Misu03/Audio-Input-Preamplifier/README.md

# Audio-Input-Preamplifier
Projected the design of an audio frequency input preamplifier consisting of an input matching network with the main audio signal sources (microphone or any other output signals from electronic audio devices), and two amplification stages.
