Misu03/Audio-Input-Preamplifier/Proiect docs/2025_433A_Nuică_Mihai_Călin_PAI_N21_SMT.docx

Universitatea “Politehnica” din Bucuresti Facultatea de Electronica, Telecomunicatii si Tehnologia Informatiei

PROIECT 1

PREAMPLIFICATOR AUDIO DE INTRARE

Student: Nuică Mihai-Călin

Grupa: 433A

Prof. Coordonator BABARADA Florin

Bucuresti, 2024

1. TEMA DE PROIECTARE

Tema de proiectare se referă la un preamplificator de audiofrecvenţă de intrare având schema bloc prezentată în Figura 1. Amplificatorul audio de intrare este compus din o reţea de adaptare la intrare cu principalele surse de semnale audio (microfon, pick-up cu doză magnetică, pick-up cu doză ceramică, radio, magnetofon sau alte ieşiri de semnal ale aparatelor audio electronice) şi două etaje de amplificare în clasa A, respectiv etajul de intrare şi etajul de ieşire care realizează amplificarea în tensiune a semnalului.

Amplificarea globală a amplificatorului audio de intrare este stabilită de reacţie negativă serie la intrare-paralel la ieşire iar alimentarea celor două etaje de amplificare este realizată de sursa de alimentare.

Reactie negativa

iesire

Microfon

Etaj de intrare A

Etaj de iesire A

Figura 1. Schema bloc a amplificatorului audio de intrare

2. DATE DE INTRARE

Principalii parametrii de intare ai amplificatorului audio sunt:

• Sensibilitatea minimă la intare Vin (mV)

• Rezistența de intrare Rin(kOhm)

• Rezistența de ieșire maximă R0M(kOhm)

• Tensiunea nominală la ieșirea amplificatorului audio de putere Vn (Vef)

Valorile folosite pentru proiectarea amplificatorului pot fi consultate în tabelul următor:

N | Vin [mV] | Rin [kΩ ] | R0M [kΩ ] | Vn [mV]
21 | 2,5 | 40 | 3 | 1,5

3. SCHEMA ELECTRONICĂ

Preamplificatorul este partea care influenţează cel mai pregnant raportul semnal zgomot, caracteristica de frecvenţă şi factorul de distorsiuni într-un lanţ de amplificare de audiofrecvenţă.

In practică există adesea şi alte semnale numite semnale false, care tind să interfereze cu semnalele dorite şi acestea se numesc în general semnale de zgomot. Un obiectiv important în proiectare este realizarea unui bun raport semnal zgomot, cu toate ca zgomotul nu poate fi eliminat complet.

Un preamplificator sensibil si relativ nezgomotos constituie o problemă importantă daca urmează ca la ieşire zgomotul sa fie minim deoarece orice zgomot din preamplificator este amplificat de fiecare etaj care urmează.

Amplificarea în tensiune este realizată de etajul de intrare şi cel de ieşire. Etajul de intrare este de tipul emitor comun cu sarcină distribuită şi este realizat cu tranzistorul T1. Etajul de ieşire este cuplat galvanic cu etajul de intrare şi este de tip emitor comun, realizat cu tranzistorul T2.

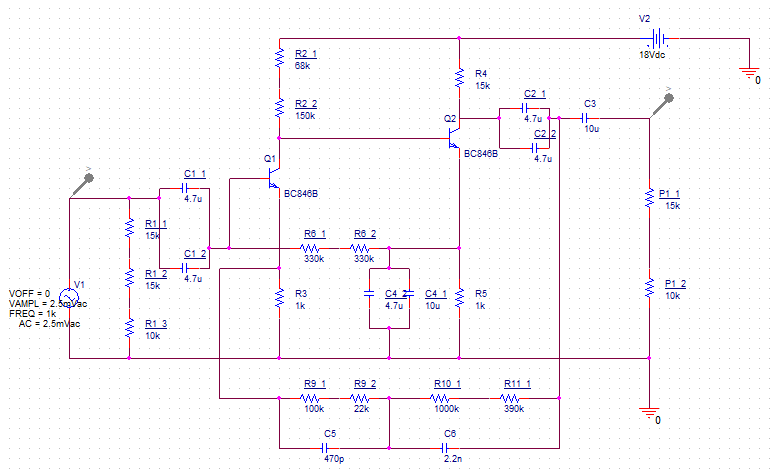
[picture p1: figure]

4. ETAJELE DE AMPLIFICARE

Având în vedere faptul că intrarea amplificatorului de putere necesită la intrare un semnal cu amplitudinea de 1,5 Vef, iar amplificatorul corector de ton sau alte etaje intermediare au amplificarea de aproximativ 5, semnalul la ieşirea preamplificatorului de intrare trebuie să aibă o amplitudine de 1,5/5=0,3Vef respectiv amplitudinea maximă de 0,3 * ∗ √2 = 0,42V. Se alege acoperitor o valoare de 0,6V (valoare instantanee maximă). Sensibilitatea la intrare asigură un nivel minim egal cu cel al unui microfon dinamic respectiv 2,5mV.

I) ALEGEREA TRANZISTORILOR T1 SI T2

Nivelul mic al semnalului de intrare impune alegerea pentru etajele de amplificare a unor tranzistoare cu zgomot mic de tip BC846B cu următoarele PSFuri:

T1: Pe baza curbelor izo-F, din catalog pentru BC846B, se alege IC1=70μA la care pentru rezistenţa generatorului Rg=2÷20k⇒F≤2dB. Se alege VCE1≥≈2V.

Din catalog în acest PSF rezultă:

h11e1 = rbe1 ≈ 150 kΩ

h21e1 = β1 ≈ 300

h22e1 = 18 μA/V

h21E1 ≈ 350

T2: Ic2 ≈ 0.8mA și VCE2 ≈ 5V

Din catalog în acest PSF rezultă:

h11e2 = rbe2 ≈ 15kΩ

h21e2 = hFE = β2 ≈ 300

h22e2 = 55 μA/V

h21E2 ≈ 170

II) AMPLIFICARE IN TENSIUNE

Amplificarea în tensiune a etajului de intrare care este de tipul emitor comun cu sarcină distribuită este:

AV, T1 = -(h11e2||(h22e1)^(-1) ||R2)/(R3)

Considerand: R2 ≫ h11e2‖h22e1 => AV,T1 ≤ -(h11e2||(h22e1)^(-1))/(R3) = -(15k||55k)/(R3) = -(11.78k)/(R3)

Pentru obținerea unor distorsiuni tranzitorii mici se impune o amplificare redusă, cu reacție locala AV,T1 ≈ -10. Din acest motiv alegem R3 = 1kΩ.

Din condițiile: R2 ≫ h11e2‖h22e1 ⁻¹

VCE1 ≈ EC − (R2 + R3)*Ic1 ≈ 2V

Se aleg R2 = 218kΩ si Ec=18V.

Se poate calcula exact VCE1:

EC=R2*(IC1+IB2)+VCE1+R3*IC1 cu IB2= (IC2)/(h21E2) ≈ 5.8μA =>

VCE1=18V-220kΩ*75.8μA-1kΩ*70μA = 1.254V este mai mare decat amplitudinea semnalului la iesirea etajului de intrare.

Considerand VR2=R2*(IC1+IB2) ≈ 16.6V şi aproximând VBE2 = 0,6V =>

VR5=EC- VR2-VBE2=0.8V

Se alege R5 = 1kΩ => IC2 = 0,8mA

Ecuația dreptei de sarcină pentru T2: Ec = (R4 + R5)*Ic2 + VCE2 =>

R4 ≈ (Ec-VR5-VCE2)/(Ic2) = (18V-0.8V-5V)/(0.8mA) = 15.25kΩ, alegem R4=15kΩ, fiind cea mai apropiata valoare intreaga.

Amplificarea în tensiune a etajului de ieșire este:

AV, T2= -(h21e2*[R2||(h22e2)^(-1) ])/(Rg+h11e2) = -(300*(15k||18k))/(55k+15k) ≈ -35

Amplificarea în tensiune a etajului de intrare este:

AV, T1= -([h11e2||(h22e1)^(-1) ]*R2)/(h11e1+(h21e1+1)*R3) *h21e1 = -(11.9k*300)/450 ≈ -7.8

Amplificarea în tensiune a preamplificatorului în buclă deschisă este:

AV= AV, T1*AV, T2= (-7.8)*(-35)= 273

III) IMPEDANTA DE IESIRE

Impedanța de intrare în buclă deschisă a preamplificatorului este:

ZinT1=[h11e1+(h21e1+1)R3]‖R6

R6 se dimensionează ținand cont de necesitatea polarizării bazei tranzistorului T1:

R6IB1 = VR5 − VBE,T1 − VR3 = 0,8 − 0,6 − 0,07 ≈ 0.13V

cu IB1= (IC1)/(h21E1) = 70/350 = 0.2μA => R6= (0.13V)/(0.2μA) = 650kΩ, alegem R6=660kΩ

ZinQ,1 = (150k + 300k)‖650k = 265kΩ

IV) DIMENSIONAREA CONDENSATORILOR

Din motive de stabilitate determinate grafic pe caracteristica BODE, alegem pentru polul dat de C4 la frecvența f4p ≈ 5 ÷ 10 Hz (7Hz).

Rezistența văzută la bornele lui C4 este:

RC4p= R5 ‖ (h11e2+R2||(h22e1)^(-1))/(h21e2) = 1k ‖ (15k+220k‖55k)/300 =165 Ω

C4 ≈ 1/(2*π*f4p*Rc4p) = 137 μF , se alege 14.7 μF (pt. a reduce nr. de condensatoare in paralel necesare)

Avand în vedere că R1 se alege astfel încat imprendanța văzută spre amplificator să fie ≈47kΩ, necesară pentru adaptarea cu doza magnetică și alegand f1 = 0,3Hz

C1= 1/(2*π*0.3*47k) = 11.29μF, se alege C1= 9.4μF

Pentru dimensionarea C2 se apreciază că impendața la bornele sale nu este mai mică de 50kΩ. Se alege f2 = 0,3Hz

C2= 1/(2*π*0.3*Rc2) = 13.8 μF, se alege C2= 9.4μF

Impedanța de ieșire a preamplificatorului fără reacție negativă este:

Zout,T2 = R4‖h22e2 ⁻¹ = 15k‖18k = 8,2kΩ

Cu reacție negativă avand în vedere necesitatea de amplificare pentru o valoare medie βr=100⁻¹ impendața de ieșire este:

Zout ≈ (Zout,T2)/(βr*Av) = (8.2k)/2.73 = 3kΩ

Se poate accepta ca valoare minima a rezistorului P1=25kΩ, valoarea maximă de aproximativ 100kΩ e impusă de intrarea în circuitul corector de ton. Valoarea lui C3 s-a ales C3=10μF pentru P1 =25kΩ.

V) REACŢIA NEGATIVĂ ŞI REŢELELE DE ADAPTARE

Pentru estimarea nivelului nominal al semnalului la ieşirea preamplificatorului cunoaştem:

• Amplitudinea nominală a semnalului la intrarea în amplificatorul final Vnom. aap = 1,5Vef

• Amplificarea circuitelor intermediare de aproximativ 5

• Atenuarea introdusă de P1 = 0,9 Þ Vout, pa = 330mV

Reţelele de adaptare se dimensionează în raport cu acest nivel şi nivelele tipice ale surselor de program. S-au adoptat următoarele categorii de surse de semnal corespunzătoare cu tema de proiectare:

Sursa | Rezistența de intrare Ri [kΩ] | Sensibilitate Vin [mV]
Microfon | 40 | 100mVef

Pentru intrarea de microfon şi pick-up magnetic se proiectează o reţea de reacţie egalizatoare, care să corecteze caracteristica de frecvenţă a dozei magnetice. S-a adoptat corecţia după norma R.I.A.A, în care se impun următoarele constante de timp: t1=318µs, t2=75µs, t3=3180µs.

Considerând o reacţie suficient de puternică astfel încât să se poată scrie: AVr=1/βr şi având βr ≈ R3/Z(ω), unde Z(ω) este impedanţa grupului format din R9, R10, C5, C6 Þ AVr ≈ Z/R3 = K * Z(ω).

Practic la 1KHz se poate considera Z(ω) ≈ R9 şi atunci AVr ≈ 330mV/2,5mV = 132 .

Þ R9 ≈ R3 * AVr = 132kΩ . Aleg R9 = 122 kΩ

Þ R10 =11,8 * R9 = 1439,6kΩ.

Se adoptă R10 = 1390KΩ.

C5 = t2 / R9 = 0,56 nF. Se alege C5 = 470 pF.

C6 = t3 / R10 = 2,1 nF. Se alege C6 = 2.2 nF

5. SIMULAREA FUNCŢIONĂRII PREAMPLIFICATORULUI AUDIO DE INTRARE

Simularea preamplificatorului audio de intrare s-a facut din punct de vedere al PSF-ului, al analizei tranzitorii și al raspunsului in frecvență. Simularea PSF-ului ne dă o bună concordantă cu datele de proiectare respectiv curenții de colector și tensiunile colector-emitor

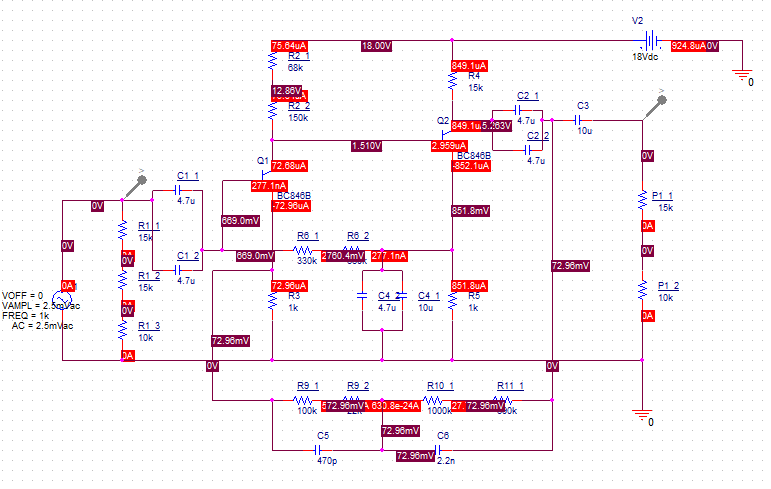
[picture p2: figure]

Simularea punctului static de functionare al preamplificatorului

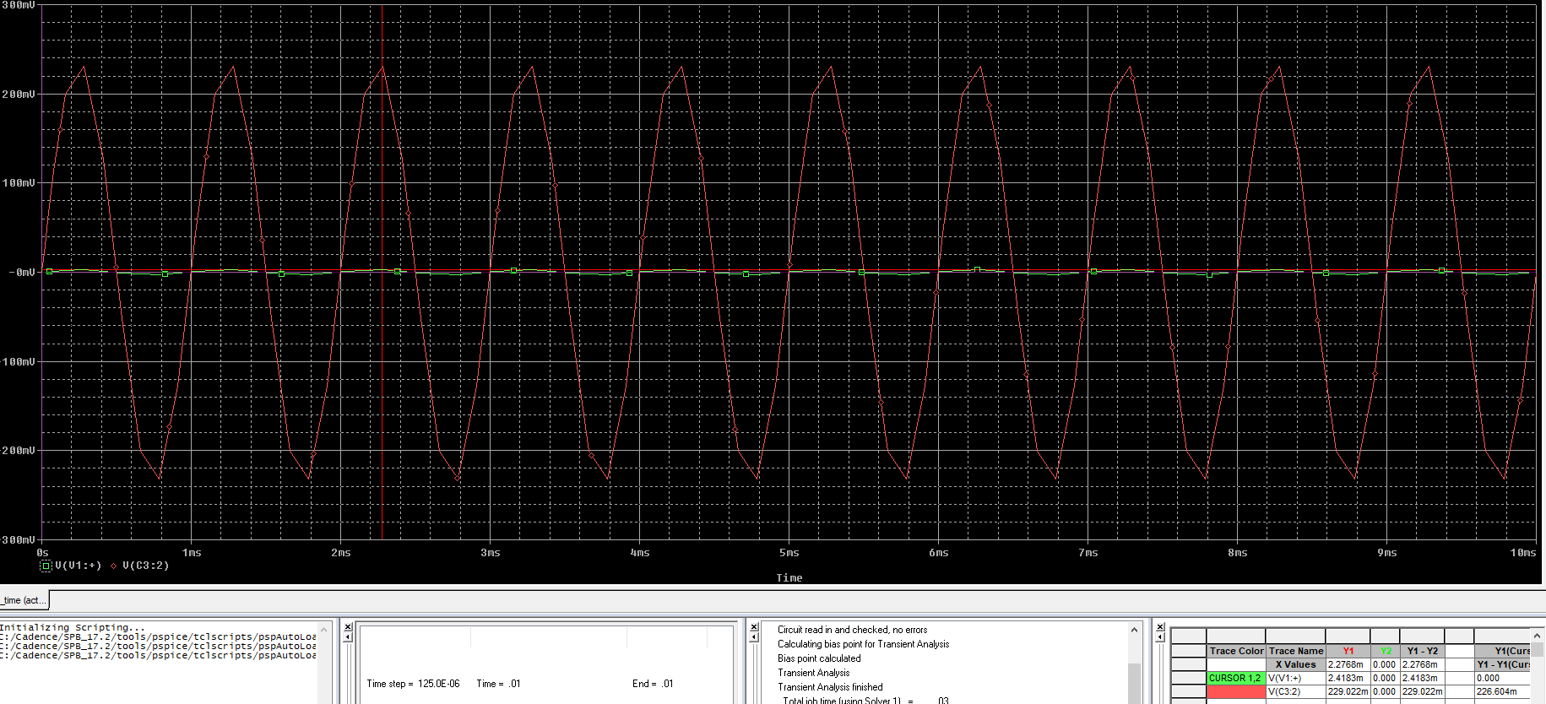
[picture p3: figure]

Simularea tranzitorie a preamplificatorului

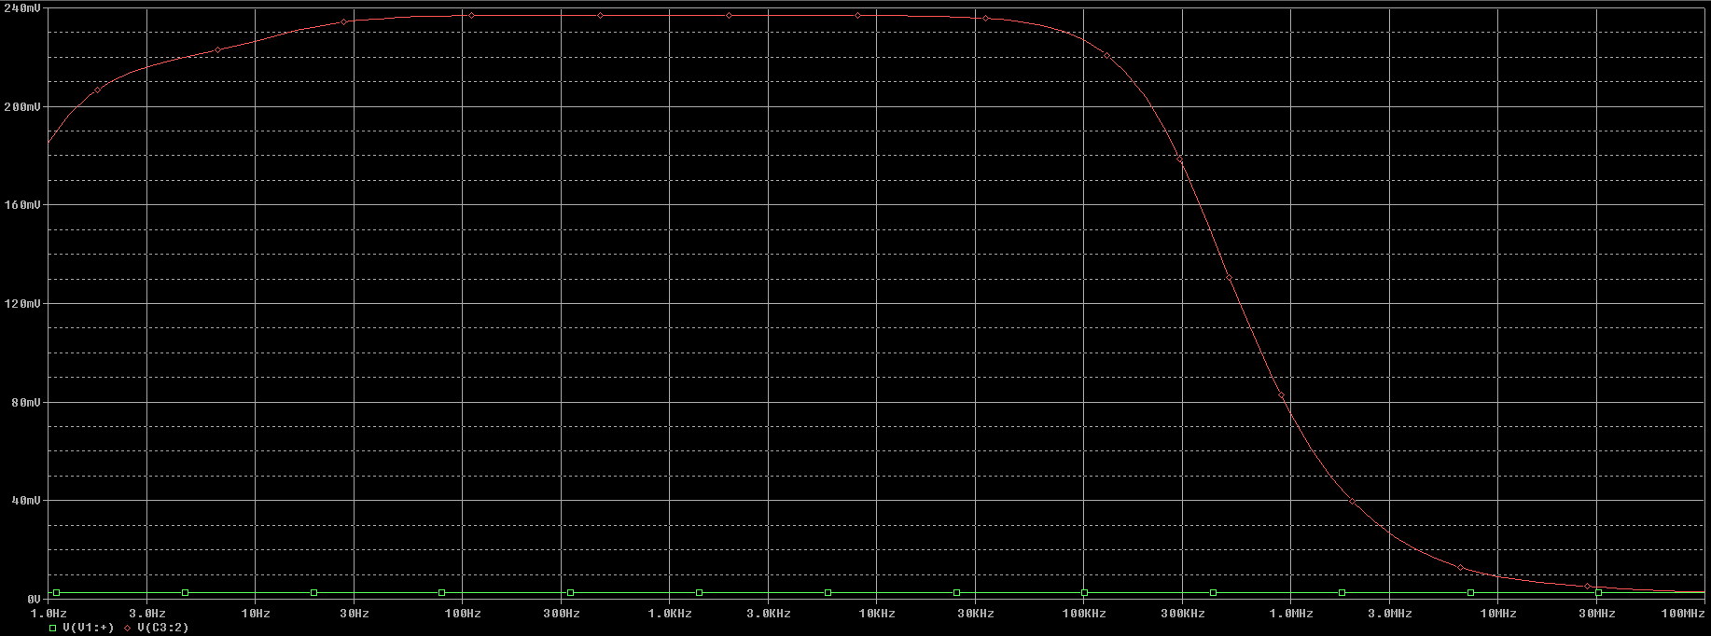
[picture p4: figure]

Simularea în frecvență a preamplificatorului

6. LISTA COMPONENTELOR

Lista componentelor preamplificatorului audio de intrare:

REZISTENTE:

R1_1=15kΩ ± 5% R1_2=15kΩ ± 5% R1_3=10kΩ ±5%

R2_1=68kΩ ±5% R2_2=150kΩ ±5%

R3=1kΩ ± 5%

R4=15kΩ ±5%

R5=1kΩ ±5%

R6_1=330kΩ ±5% R6_2=330kΩ ±5%

R9_1=100kΩ ±5% R9_2=22kΩ ±5%

R10_1=1MΩ ±5% R10_2=390kΩ ±5%

P1_1=15kΩ P1_2=10kΩ

CONDENSATORI

C1_1=C1_2=C2_1=C2_2=C4_2 = 4.7uF

C3=C4_1=10uF

C5=470pF

C6=2.2nF

TRANZISTORI

T1=T2=BC846B

6. FISIERELE GERBER

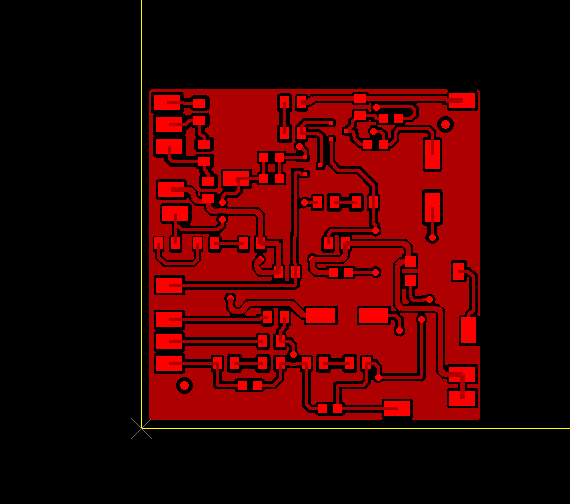
[picture p5: figure]

TOP

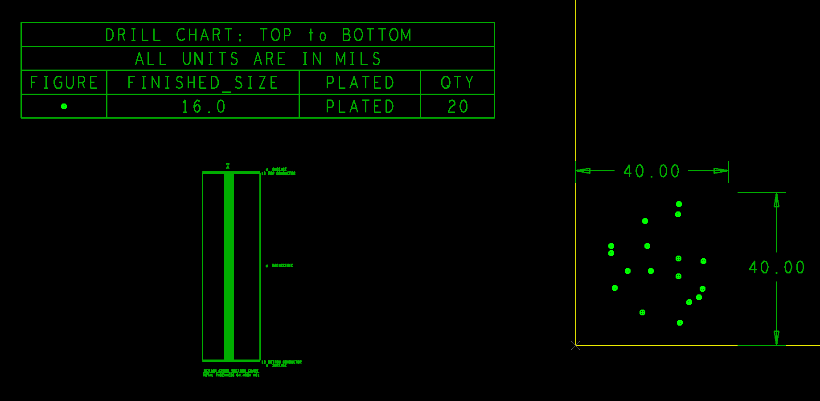
[picture p6: figure]

FAB

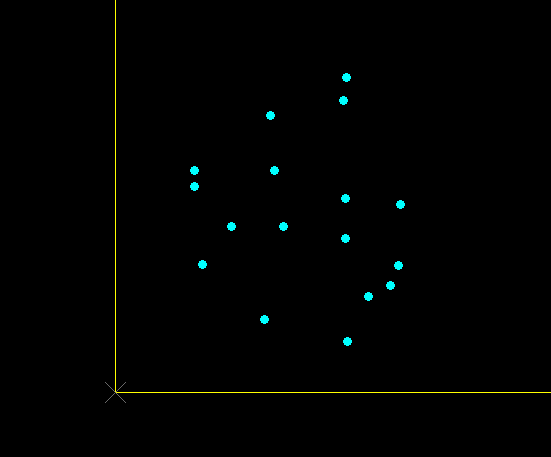
[picture p7: figure]

SMBOT

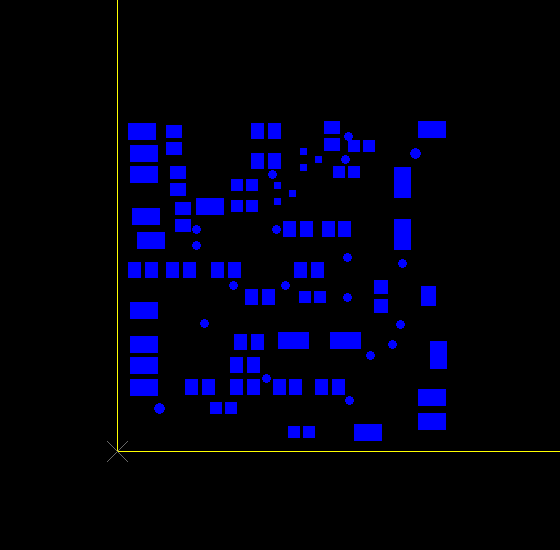
[picture p8: figure]

SMTOP

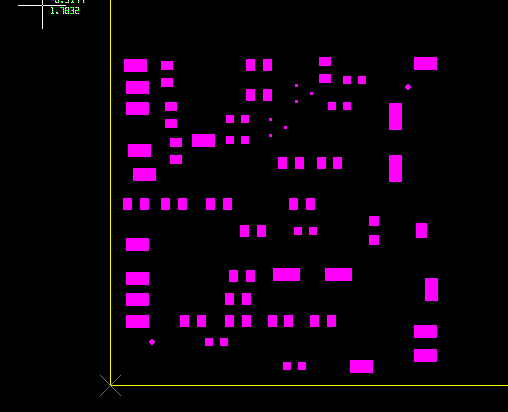
[picture p9: figure]

SPTOP

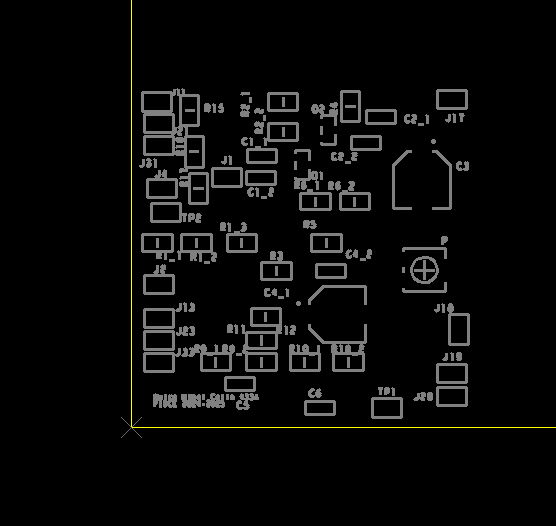
[picture p10: figure]

SSTOP

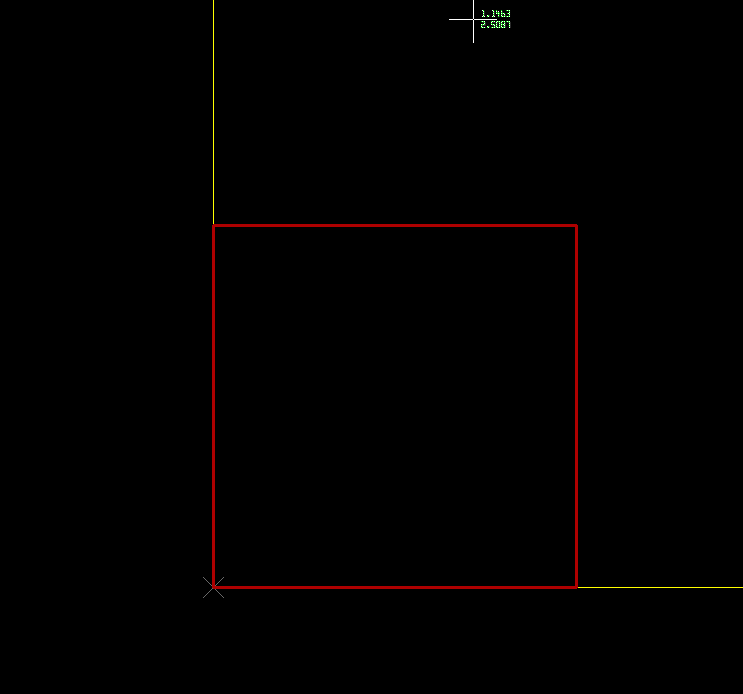
[picture p11: figure]

BO

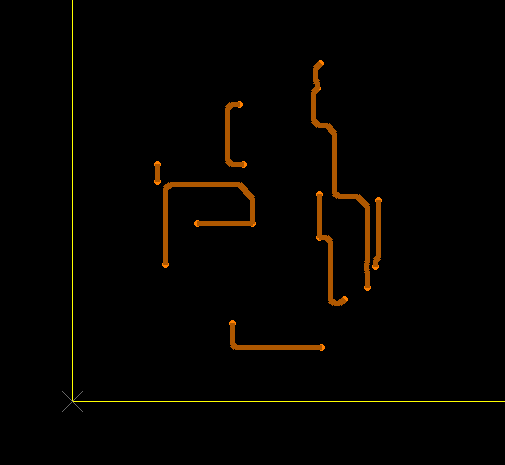
[picture p12: figure]

BOTTOM

7. Realizare si punere in functiune

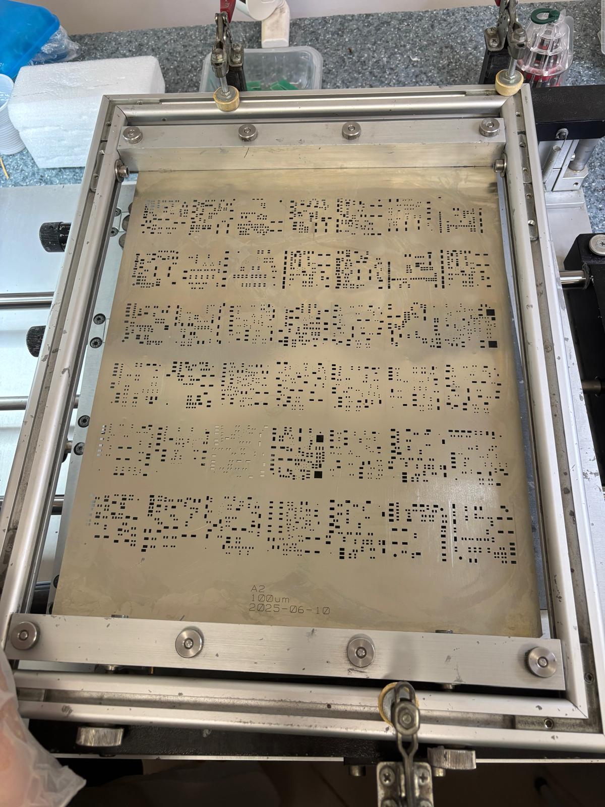
[picture p13: figure]
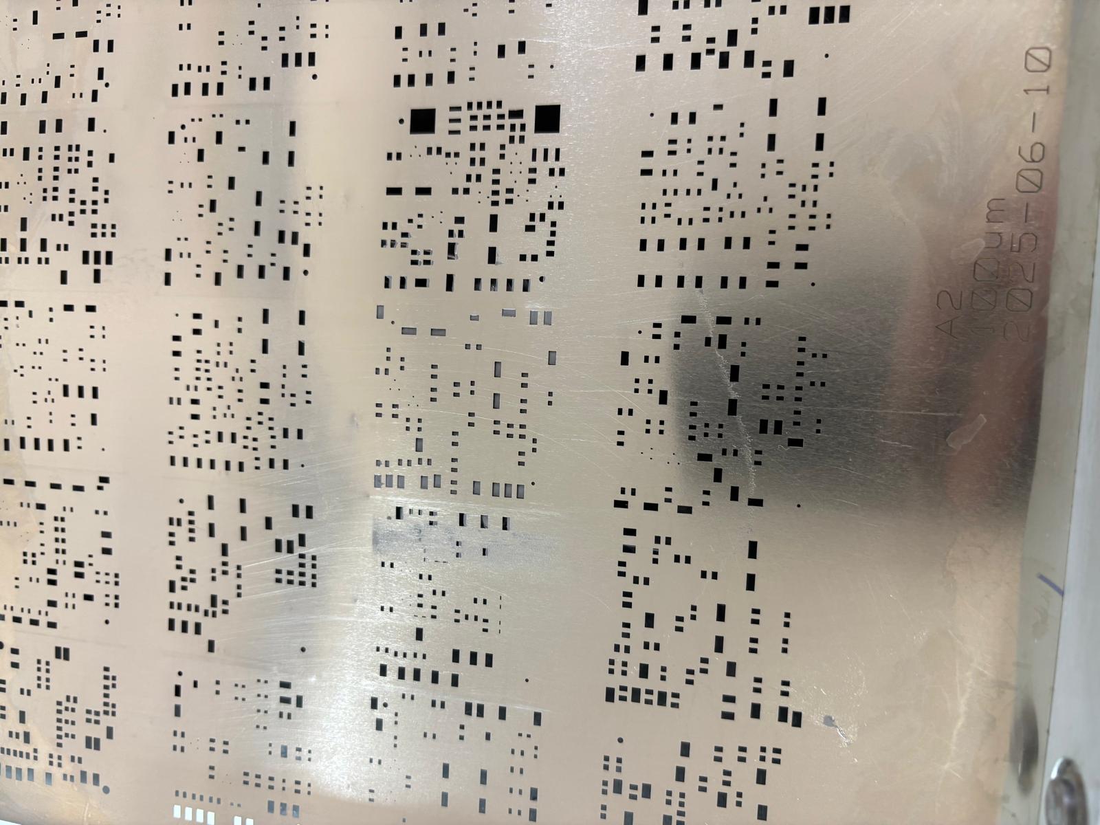
[picture p14: figure]
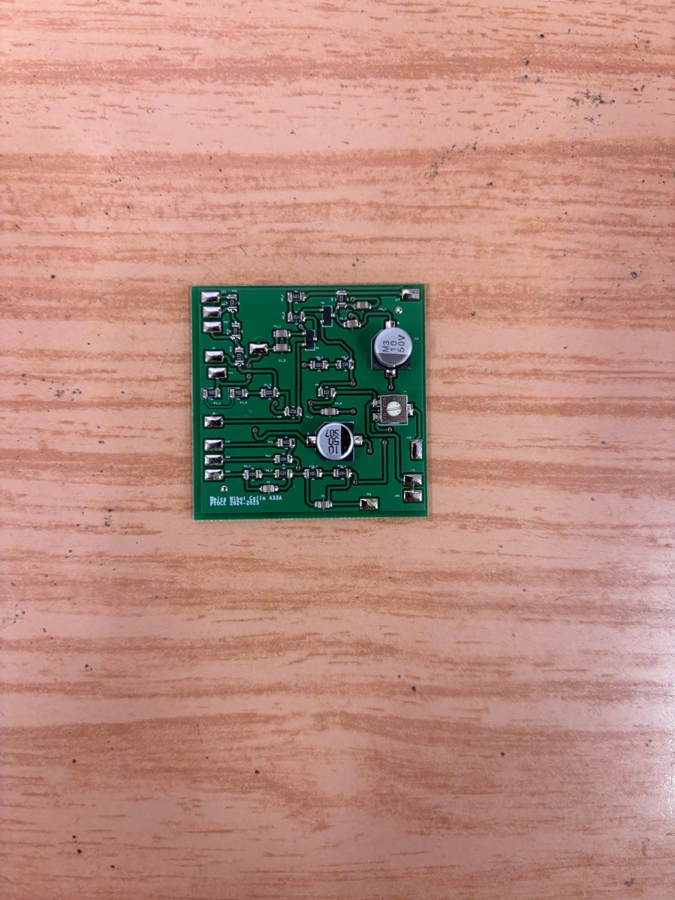
[picture p15: figure]

PAI în stadiu final

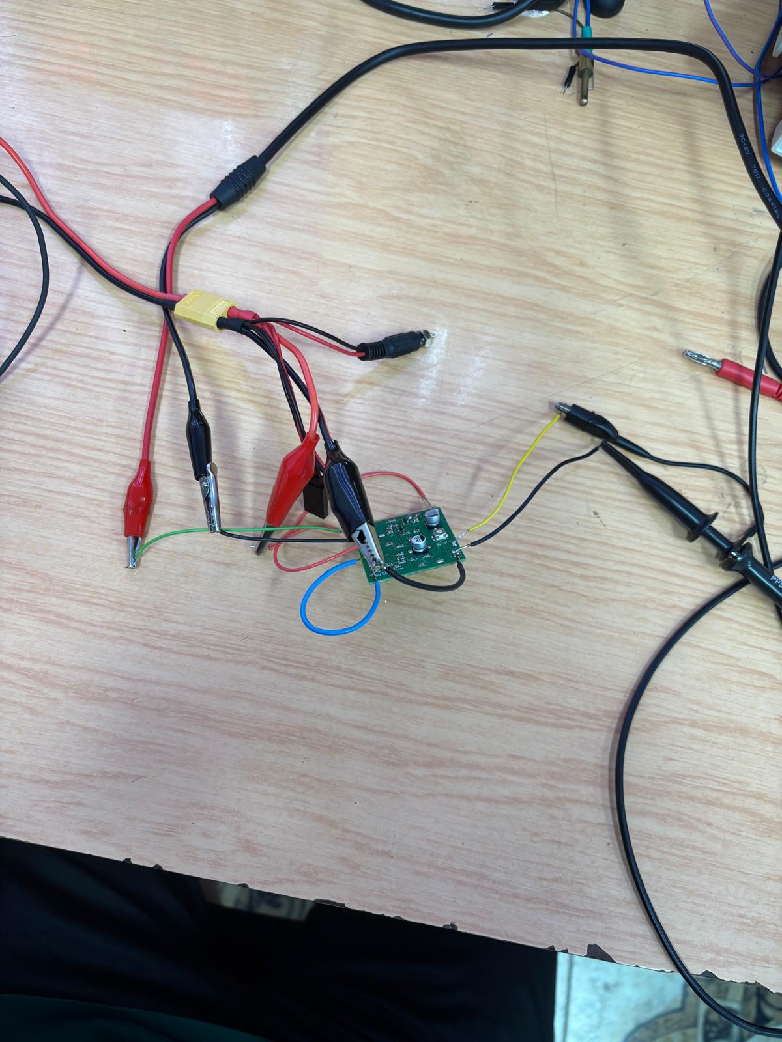
[picture p16: figure]

Conectarea la generatorul de semnal, Vcc, osciloscop

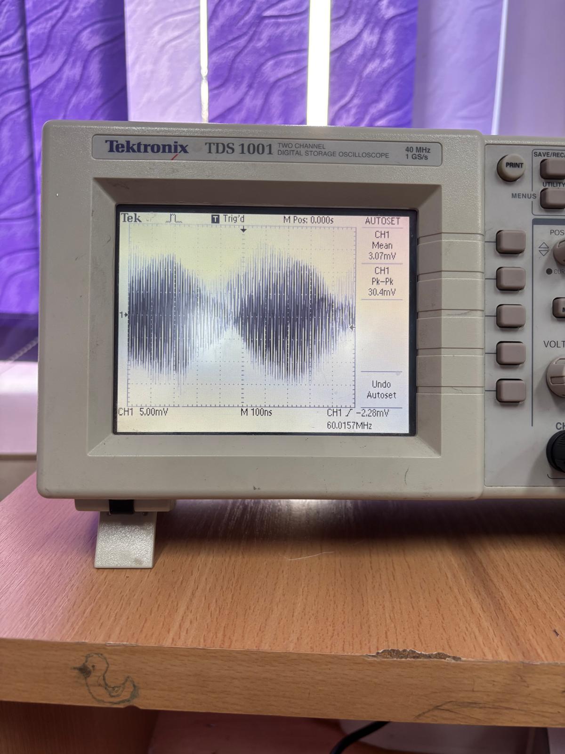
[picture p17: figure]

Semnalul de ieșire

8. Concluzii finale

Am setat generatorul de semnal cu semnal sinusoidal de amplitudine ±40 mV. Am conectat generatorul la intrarea PAI, apoi am conectat firele de alimentare (Vcc + GND). Am conectat un osciloscop la ieșirea PAI pt. a vizualiza forma de undă și amplitudinea semnalului de ieșire. Din păcate, rezultatul este unul nedorit, întrucât amplitudinea semnalului de ieșire este aproximativ egală cu cea a semnalului de intrare, ceea ce denotă că circuitul nu își îndeplinește funcția, anume de a amplifica semnalul de intrare. Acest fapt se poate datora:

→ lipirii incorecte a firelor ce leagă circuitul cu cele trei aparate menționate anterior.
→ setării incorecte a generatorului / sursei de alimentare
→ nefuncționării firelor utilizate (atât cele lipite pe PAI, cât și cele ale aparatelor)
→ alegerii eronate a unor componente în stadiul de proiectare
→ nefuncționării unor componente

BIBLIOGRAFIE

Florin BABARADA, „Proiectarea circuitelore electronice de audiofrecvență”,

Editura Printech, 2003
