Misu03/Audio-Input-Preamplifier/Layout/PCB.png

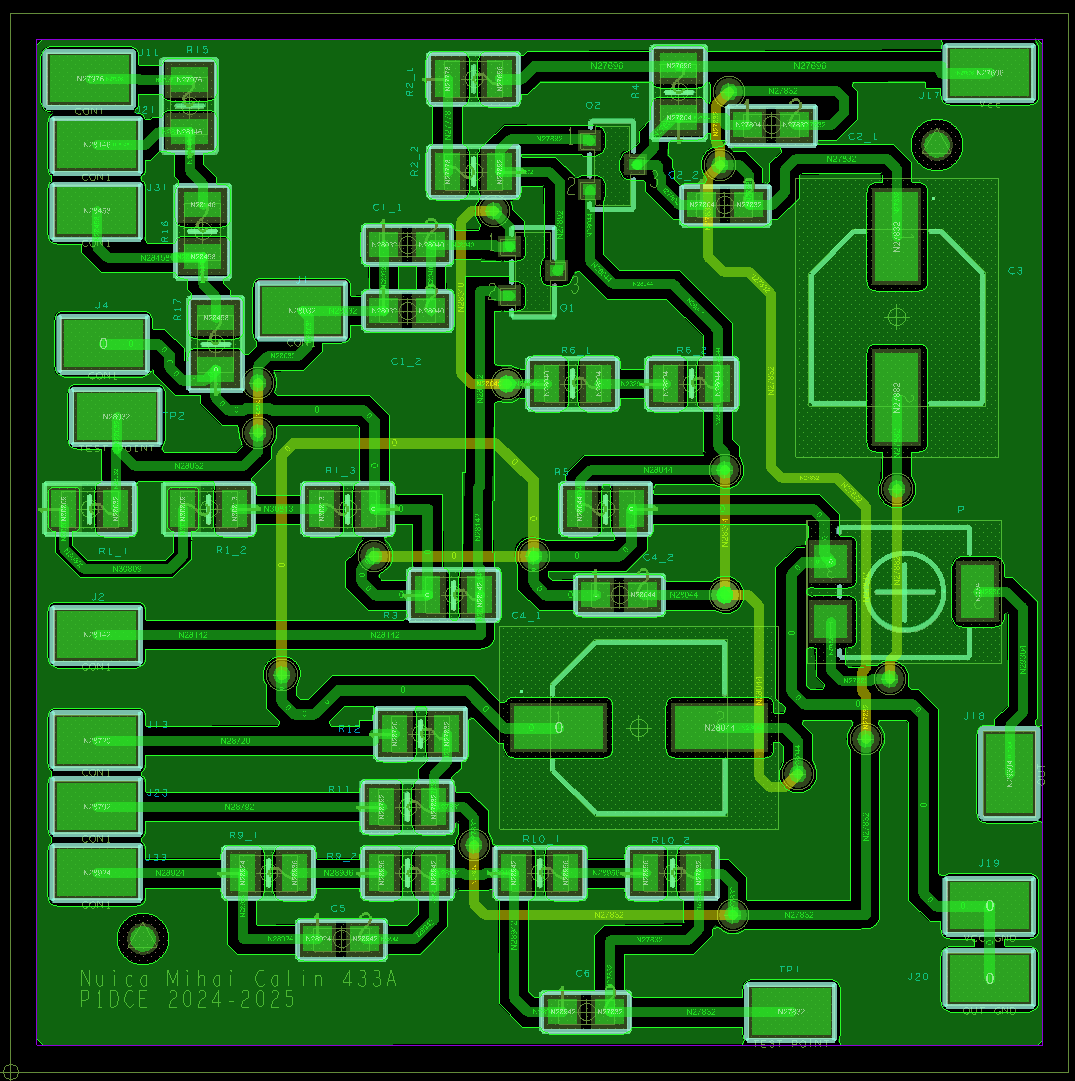
Layout/PCB.png
