Misu03/Audio-Input-Preamplifier/Schema_bloc.png

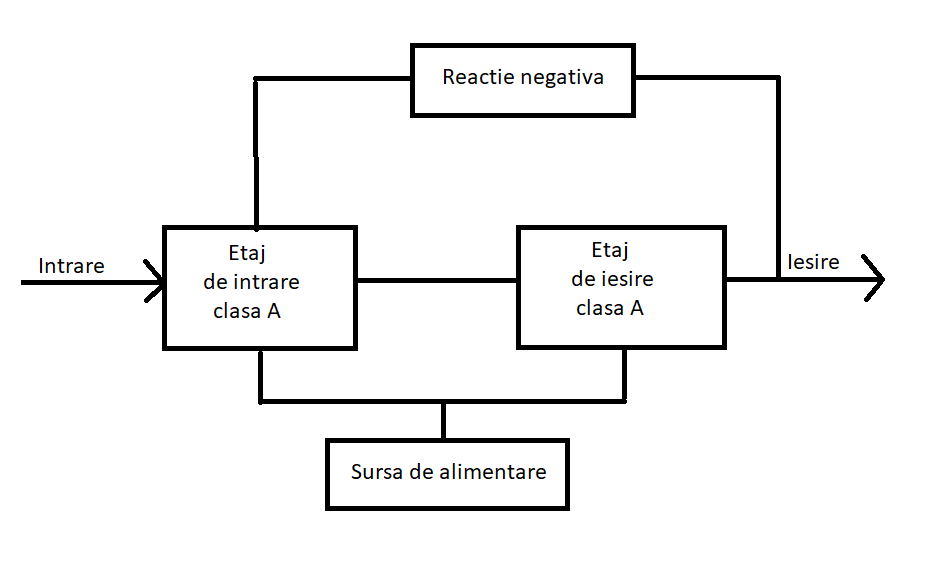
Schema_bloc.png
