Misu03/Audio-Input-Preamplifier/Schematics/p1_Nuica_Mihai_Calin_433A/p1_2-PSpiceFiles/SCHEMATIC1/ac_time/ac_time.cir

** Profile: "SCHEMATIC1-ac_time"  [ C:\Users\calin1q2w\Desktop\P1_2024_433A_Nuica_Mihai_Calin_PAI_N21_OrCAD\Schematics\p1\p1_2-pspicefiles\schematic1\ac_time.sim ] 

** Creating circuit file "ac_time.cir" 
** WARNING: THIS AUTOMATICALLY GENERATED FILE MAY BE OVERWRITTEN BY SUBSEQUENT SIMULATIONS

*Libraries: 
* Profile Libraries :
* Local Libraries :
* From [PSPICE NETLIST] section of C:\Users\calin1q2w\AppData\Roaming\SPB_Data\cdssetup\OrCAD_PSpice\17.2.0\PSpice.ini file:
.lib "nomd.lib" 

*Analysis directives: 
.TRAN  0 5ms 0 
.OPTIONS ADVCONV
.PROBE64 V(alias(*)) I(alias(*)) W(alias(*)) D(alias(*)) NOISE(alias(*)) 
.INC "..\SCHEMATIC1.net" 


.END
