Misu03/Audio-Input-Preamplifier/(list of files, drawings)

Other design files:
Schematics/p1_Nuica_Mihai_Calin_433A/P1_2.DSN
Schematics/p1_Nuica_Mihai_Calin_433A/p1_2.opj
